aws-samples/amazon-freertos-iot-conveyor-belt/README.md

## IoT Conveyor Belt

A 3D Printed Conveyor belt that runs Amazon FreeRTOS to control conveyor direction and report conveyor telemetry data using Amazon's IoT service.

## License

This library is licensed under the Apache 2.0 License.
