aws-samples/amazon-freertos-iot-conveyor-belt/conveyor-design-files/README.md

# Assembly Instructions Coming Soon!
We are currently working on detailed assembly instructions and a bill of materials so you can build a conveyor belt your self. [Check out the assembly-instructions branch to see the work in progress](
https://github.com/aws-samples/amazon-freertos-iot-conveyor-belt/tree/assembly-instructions/conveyor-design-files/assembly-instructions)
