aws-samples/amazon-freertos-iot-conveyor-belt/conveyor-design-files/assembly-instructions/BOM.md

# 3D Printed Parts

| Part | Quantity | Link |
|---|---|---|
| Front | 1 | https://github.com/aws-samples/amazon-freertos-iot-conveyor-belt/blob/master/conveyor-design-files/3d-stl-files/conveyor-front-one-piece.stl |
| Back | 1 | https://github.com/aws-samples/amazon-freertos-iot-conveyor-belt/blob/master/conveyor-design-files/3d-stl-files/conveyor-back-one-piece.stl |
| Center | 1 | https://github.com/aws-samples/amazon-freertos-iot-conveyor-belt/blob/master/conveyor-design-files/3d-stl-files/conveyor-center.stl |
| Belt Pulley | 2 | https://github.com/aws-samples/amazon-freertos-iot-conveyor-belt/blob/master/conveyor-design-files/3d-stl-files/conveyor-belt-pully-v2.stl |
| Drive Belt Cover | 1 | https://github.com/aws-samples/amazon-freertos-iot-conveyor-belt/blob/master/conveyor-design-files/3d-stl-files/conveyor-drive-belt-cover.stl |
| Switch Cover | 1 | https://github.com/aws-samples/amazon-freertos-iot-conveyor-belt/blob/master/conveyor-design-files/3d-stl-files/conveyor-switch-cover.stl |
| Conveyor Leg | 2 | https://github.com/aws-samples/amazon-freertos-iot-conveyor-belt/blob/master/conveyor-design-files/3d-stl-files/conveyor-leg.stl |
| Rear Access Port | 1 | https://github.com/aws-samples/amazon-freertos-iot-conveyor-belt/blob/master/conveyor-design-files/3d-stl-files/conveyor-back-access-port-cover.stl |

# Electrical Components
| Part | Quantity | Link |
|---|---|---|
| Circuit Board | 1 | https://github.com/aws-samples/amazon-freertos-iot-conveyor-belt/tree/master/conveyor-design-files/pcb-files |
| ESP32 DevKit V1 | 1 | https://www.amazon.com/gp/product/B0718T232Z/ref=oh_aui_detailpage_o02_s00?ie=UTF8&psc=1 |
| DRV8834 Stepper Controller | 1 | https://www.pololu.com/product/2134 |
| NEMA17 Stepper Motor | 1 | https://www.amazon.com/gp/product/B01GNAN2U0/ref=oh_aui_detailpage_o08_s03?ie=UTF8&psc=1 |
| 100uF Capacitor | 1 | https://www.amazon.com/Bluesky-50PCS-Radial-Electrolytic-Capacitor/dp/B01K9IGBBY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 |
| ADXL335 | 1 | https://www.amazon.com/gp/product/B00NAY2TUC/ref=oh_aui_detailpage_o01_s00?ie=UTF8&psc=1 |
| A1120 Hall Effect Sensor | 1 | https://www.amazon.com/gp/product/B00SWK15ZE/ref=ppx_yo_dt_b_asin_title_o04_s03?ie=UTF8&psc=1 |
| USB Micro-B Breakout | 1 | https://www.amazon.com/gp/product/B00KLDPZVU/ref=ppx_yo_dt_b_asin_title_o05_s05?ie=UTF8&psc=1 |
| Toggle Switch | 1 | https://www.amazon.com/gp/product/B0725V1Z54/ref=oh_aui_detailpage_o09_s00?ie=UTF8&psc=1 |
| Ribbon Cable | 1 | https://www.amazon.com/Ribbon-Cable-10-wire-15ft/dp/B007R9SQQM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 |
| 2.54mm 3P Screw Terminal | 2 | https://www.amazon.com/gp/product/B07DG4798T/ref=oh_aui_detailpage_o05_s00?ie=UTF8&psc=1 |
| 2.54mm 2p Screw Terminal | 3 | https://www.amazon.com/gp/product/B07DG3GM42/ref=oh_aui_detailpage_o05_s00?ie=UTF8&psc=1 |
| 2.54mm female headers | 1 | https://www.amazon.com/ZYAMY-2-54mm-Female-Straight-Connector/dp/B0778F2MLW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 |
# Mechanical Components
| Part | Quantity | Link |
|---|---|---|
| 300H200 Timing Belt | 1 | https://www.amazon.com/PowerDrive-300H200-WOODS-MANUFACTURING-Replacement/dp/B00ISC73LG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 |
| 200 Tooth GT2 Timing Belt | 1 | https://www.amazon.com/gp/product/B074W229W1/ref=oh_aui_detailpage_o00_s01?ie=UTF8&psc=1 |
| 60 Tooth GT2 Timing Pully (8mm Bore) | 1 | https://www.amazon.com/gp/product/B01G1N1CI8/ref=oh_aui_detailpage_o00_s01?ie=UTF8&psc=1 |
| 16 Tooth GT2 Timing Pully (5mm Bore) | 1 | https://www.amazon.com/gp/product/B019GI5DVC/ref=od_aui_detailpages01?ie=UTF8&psc=1 |
| 608 Bearings | 4 | https://www.amazon.com/8x22x7-Shielded-Greased-Miniature-Bearings/dp/B00NX23HGQ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 |
| 100mm 8mm Threaded Rod | 2 | https://www.amazon.com/gp/product/B01B2WK13U/ref=ppx_yo_dt_b_asin_title_o02_s00?ie=UTF8&psc=1 |
| 6mm magnets | 9 | https://www.amazon.com/gp/product/B075RZ82HP/ref=oh_aui_detailpage_o00_s00?ie=UTF8&psc=1 |
| M3 Heat Set Inserts | 50 | https://www.amazon.com/gp/product/B077CL322T/ref=oh_aui_detailpage_o00_s01?ie=UTF8&psc=1 |
| M3X6mm Set Screw | 4 | https://www.amazon.com/uxcell-M3x6mm-Stainless-Socket-Screws/dp/B01AXVS7RS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 |
| M3X8mm Hex Screw | 50 | https://www.amazon.com/gp/product/B01M5DWCOW/ref=oh_aui_detailpage_o00_s01?ie=UTF8&psc=1 |
| M3X20mm Hex Screw | 4 | https://www.amazon.com/gp/product/B015A30R1I/ref=oh_aui_detailpage_o01_s00?ie=UTF8&psc=1 |
| M3 Washers | 4 | https://www.amazon.com/M3x6mmx0-5mm-Stainless-Steel-Washer-100Pcs/dp/B015A39NCC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 |
| M8 Nylock Hex Nut | 7 | https://www.amazon.com/uxcell-1-25mm-Stainless-Nylock-Insert/dp/B01M28GRLR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 |
| M2X4mm Self Tapping Screw | 2 | https://www.amazon.com/gp/product/B0775ZKB2H/ref=ppx_yo_dt_b_asin_title_o04_s00?ie=UTF8&psc=1 |
