aws-samples/amazon-freertos-iot-conveyor-belt/conveyor-design-files/3d-stl-files/conveyor-belt-pully-v2.stl

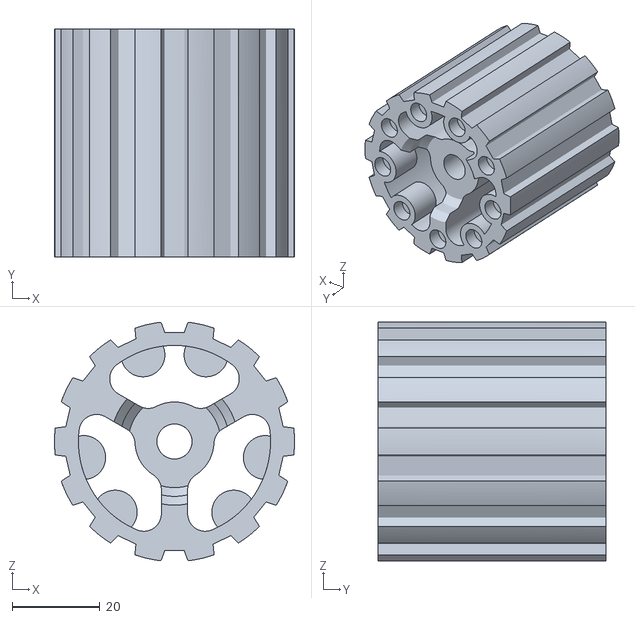
[picture p10: CAD file, 2019-09-26]
conveyor-design-files/3d-stl-files/conveyor-belt-pully-v2.stl
54.7 x 52.0 x 54.3
