aws-samples/amazon-freertos-iot-conveyor-belt/conveyor-design-files/3d-stl-files/conveyor-shortleg.stl

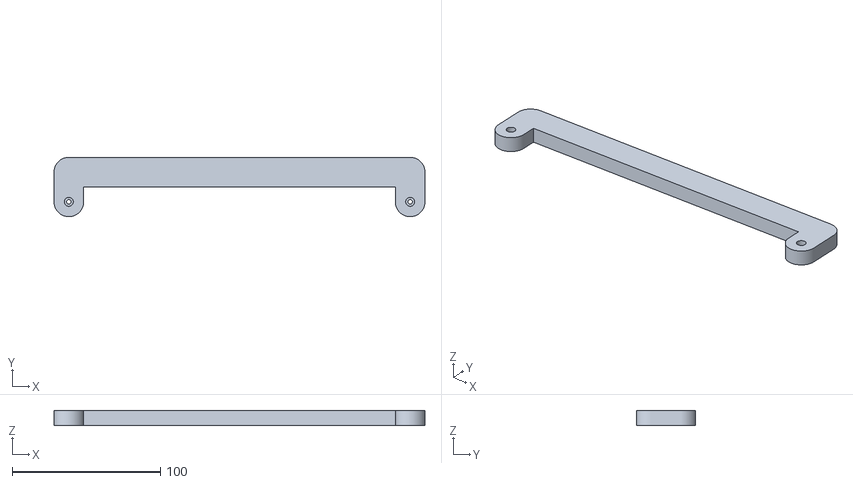
[picture p11: CAD file, 2019-01-02]
conveyor-design-files/3d-stl-files/conveyor-shortleg.stl
250.0 x 40.0 x 10.0
