aws-samples/amazon-freertos-iot-conveyor-belt/conveyor-design-files/3d-stl-files/conveyor-center.stl

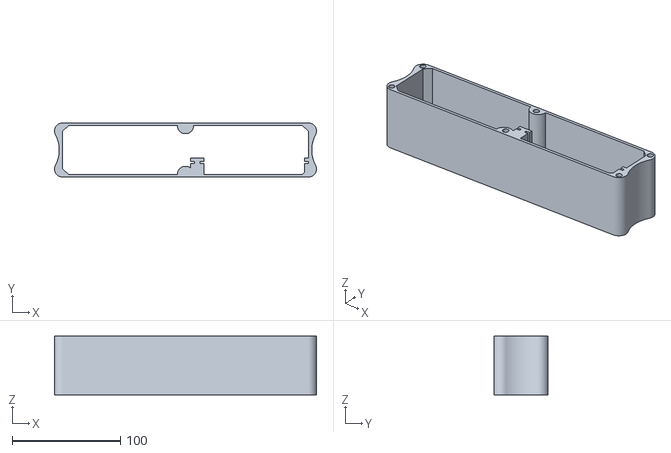
[picture p12: CAD file, 2018-11-28]
conveyor-design-files/3d-stl-files/conveyor-center.stl
241.7 x 50.0 x 54.0
