aws-samples/amazon-freertos-iot-conveyor-belt/conveyor-design-files/3d-stl-files/conveyor-drive-belt-cover.stl

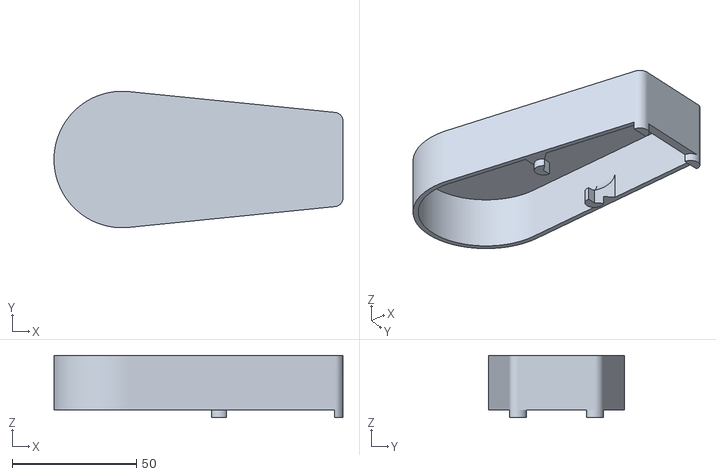
[picture p13: CAD file, 2018-11-28]
conveyor-design-files/3d-stl-files/conveyor-drive-belt-cover.stl
116.5 x 55.0 x 25.0
