aws-samples/amazon-freertos-iot-conveyor-belt/conveyor-design-files/3d-stl-files/conveyor-back-one-piece.stl

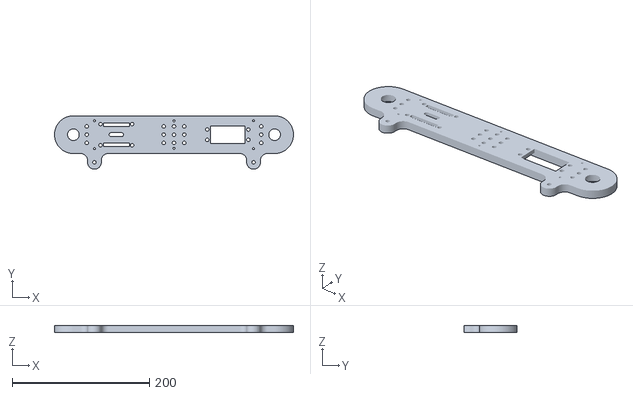
[picture p16: CAD file, 2018-11-28]
conveyor-design-files/3d-stl-files/conveyor-back-one-piece.stl
348.0 x 77.8 x 10.0
