aws-samples/amazon-freertos-iot-conveyor-belt/conveyor-design-files/3d-stl-files/conveyor-front-left.stl

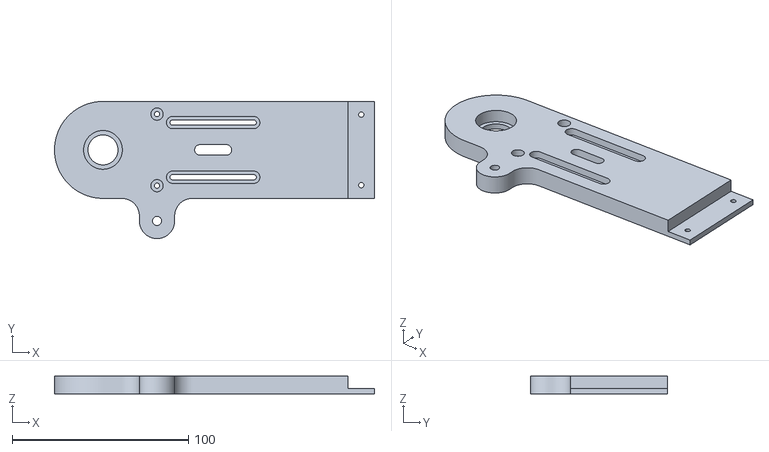
[picture p17: CAD file, 2018-11-28]
conveyor-design-files/3d-stl-files/conveyor-front-left.stl
181.5 x 77.8 x 10.0
