aws-samples/amazon-freertos-iot-conveyor-belt/conveyor-design-files/3d-stl-files/deeplens-attachment.stl

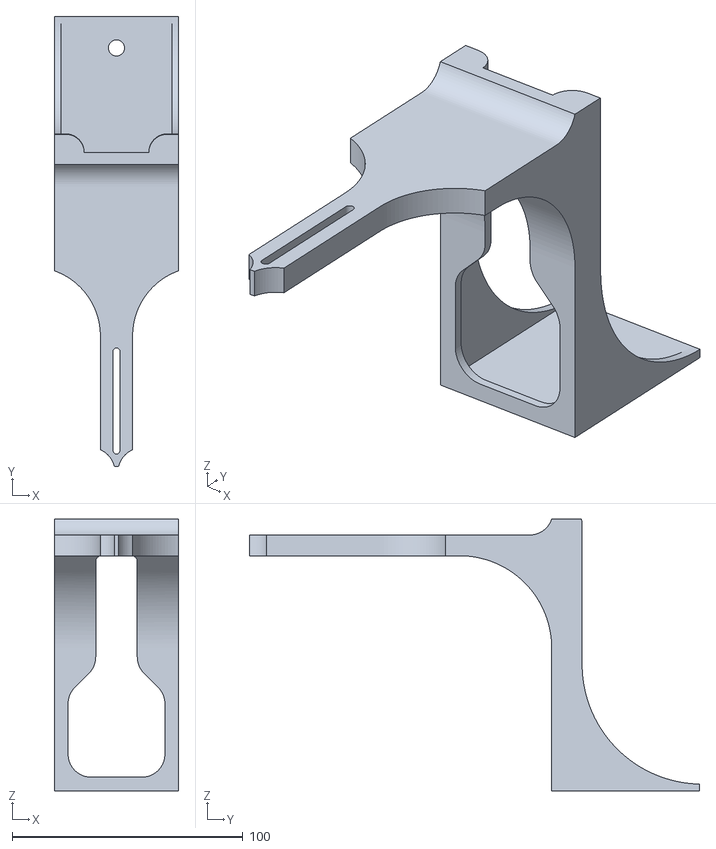
[picture p18: CAD file, 2018-11-28]
conveyor-design-files/3d-stl-files/deeplens-attachment.stl
54.0 x 195.4 x 118.0
