aws-samples/amazon-freertos-iot-conveyor-belt/conveyor-design-files/3d-stl-files/conveyor-back-access-port-cover.stl

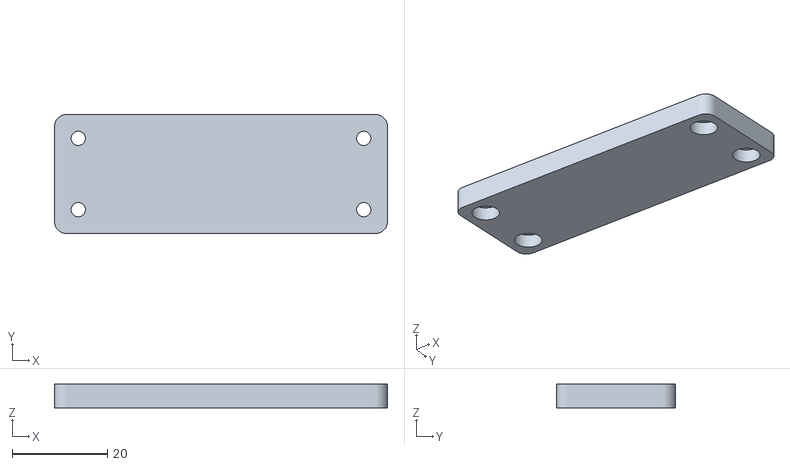
[picture p19: CAD file, 2018-11-28]
conveyor-design-files/3d-stl-files/conveyor-back-access-port-cover.stl
70.0 x 25.0 x 5.00
