aws-samples/amazon-freertos-iot-conveyor-belt/conveyor-design-files/3d-stl-files/conveyor-leg.stl

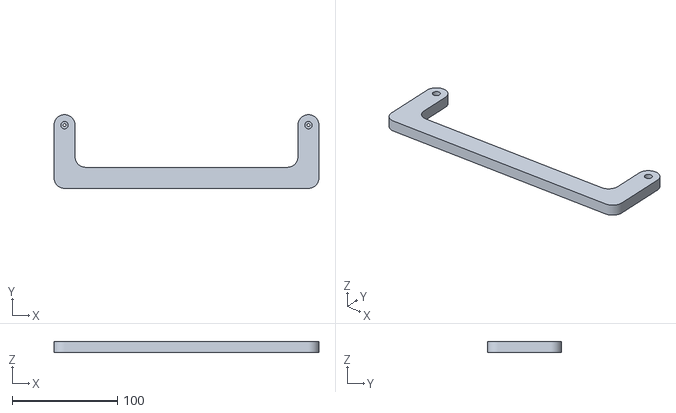
[picture p20: CAD file, 2018-11-28]
conveyor-design-files/3d-stl-files/conveyor-leg.stl
251.7 x 70.0 x 10.0
