aws-samples/amazon-freertos-iot-conveyor-belt/conveyor-design-files/3d-stl-files/conveyor-switch-cover.stl

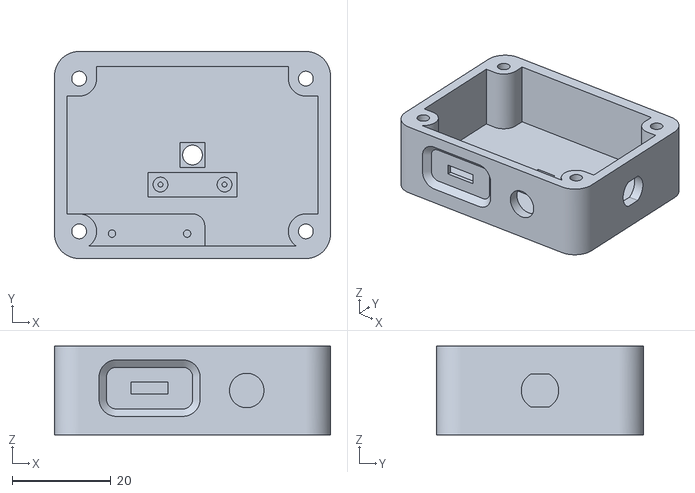
[picture p21: CAD file, 2018-11-28]
conveyor-design-files/3d-stl-files/conveyor-switch-cover.stl
56.0 x 42.0 x 18.0
