aws-samples/amazon-freertos-iot-conveyor-belt/conveyor-design-files/3d-stl-files/conveyor-belt-pully.stl

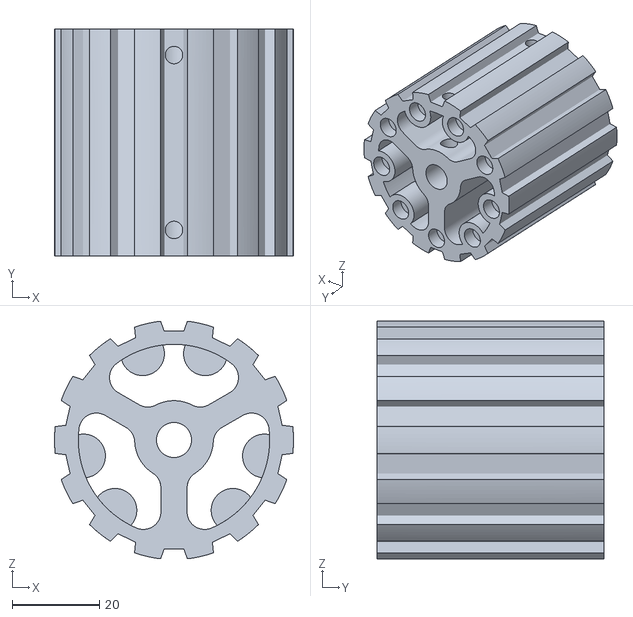
[picture p22: CAD file, 2018-11-28, an earlier design]
conveyor-design-files/3d-stl-files/conveyor-belt-pully.stl
54.7 x 52.0 x 54.3
