aws-samples/amazon-freertos-iot-conveyor-belt/(list of files, cad)

Other CAD files:
conveyor-design-files/3d-stl-files/conveyor-front-one-piece.stl
conveyor-design-files/3d-stl-files/conveyor-back-left.stl
