aws-samples/amazon-freertos-iot-conveyor-belt/conveyor-design-files/assembly-instructions/images/wiring_routing.jpg

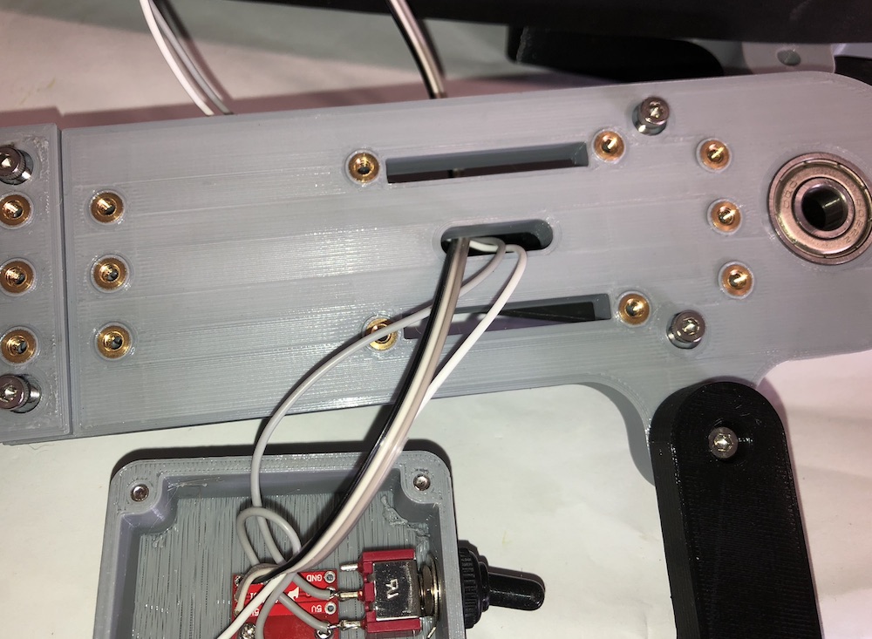
conveyor-design-files/assembly-instructions/images/wiring_routing.jpg
