aws-samples/amazon-freertos-iot-conveyor-belt/conveyor-design-files/pcb-files/conveyor-pcb.brd

## EAGLE design conveyor-design-files/pcb-files/conveyor-pcb.brd (2018-11-28)

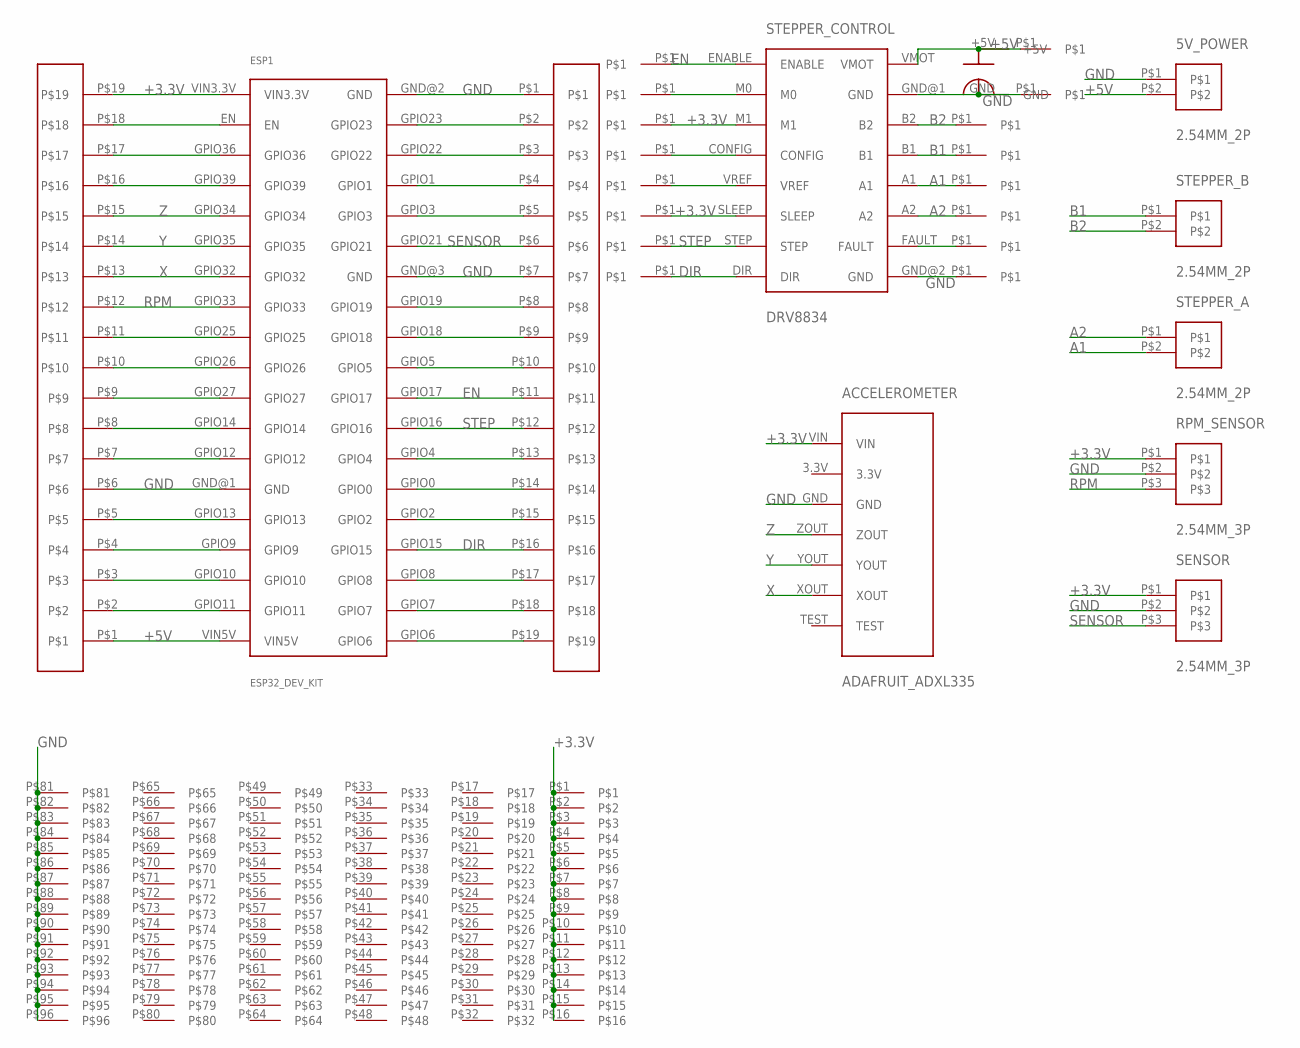
[picture p46: schematic conveyor-pcb.sch]

Parts:
5V_POWER: 2.54MM_2P
ACCELEROMETER: ADAFRUIT_ADXL335
ESP1: ESP32_DEV_KIT
RPM_SENSOR: 2.54MM_3P
SENSOR: 2.54MM_3P
STEPPER_A: 2.54MM_2P
STEPPER_B: 2.54MM_2P
STEPPER_CONTROL: DRV8834
U$1, U$2: 19PINHEADER
U$3: PERFBOARD_CONVEYOR
U$4, U$5, U$6, U$7, U$8, U$9, U$10, U$11, U$12, U$13, U$14, U$15, U$16, U$17, U$18, U$19: 1PIN_HEADER
U$20: CAP_100UF

Connections:
+3.3V: ACCELEROMETER.VIN, ESP1.VIN3.3V, RPM_SENSOR.P$1, SENSOR.P$1, STEPPER_CONTROL.M1, STEPPER_CONTROL.SLEEP, U$2.P$19, U$3.P$1, U$3.P$2, U$3.P$3, U$3.P$4, U$3.P$5, U$3.P$6, U$3.P$7, U$3.P$8, U$3.P$9, U$3.P$10, U$3.P$11, U$3.P$12, U$3.P$13, U$3.P$14, U$3.P$15, U$3.P$16, U$6.P$1, U$9.P$1
+5V: 5V_POWER.P$2, ESP1.VIN5V, STEPPER_CONTROL.VMOT, U$2.P$1, U$19.P$1, U$20.+5V
A1: STEPPER_A.P$2, STEPPER_CONTROL.A1, U$15.P$1
A2: STEPPER_A.P$1, STEPPER_CONTROL.A2, U$14.P$1
B1: STEPPER_B.P$1, STEPPER_CONTROL.B1, U$16.P$1
B2: STEPPER_B.P$2, STEPPER_CONTROL.B2, U$17.P$1
DIR: ESP1.GPIO15, STEPPER_CONTROL.DIR, U$1.P$16, U$11.P$1
EN: ESP1.GPIO17, STEPPER_CONTROL.ENABLE, U$1.P$11, U$4.P$1
GND: 5V_POWER.P$1, ACCELEROMETER.GND, ESP1.GND@1 (GND), ESP1.GND@2 (GND), ESP1.GND@3 (GND), RPM_SENSOR.P$2, SENSOR.P$2, STEPPER_CONTROL.GND@1 (GND), STEPPER_CONTROL.GND@2 (GND), U$1.P$1, U$1.P$7, U$2.P$6, U$3.P$81, U$3.P$82, U$3.P$83, U$3.P$84, U$3.P$85, U$3.P$86, U$3.P$87, U$3.P$88, U$3.P$89, U$3.P$90, U$3.P$91, U$3.P$92, U$3.P$93, U$3.P$94, U$3.P$95, U$3.P$96, U$12.P$1, U$18.P$1, U$20.GND
unnamed: STEPPER_CONTROL.M0, U$5.P$1
unnamed: STEPPER_CONTROL.CONFIG, U$7.P$1
unnamed: STEPPER_CONTROL.VREF, U$8.P$1
unnamed: ESP1.GPIO11, U$2.P$2
unnamed: ESP1.GPIO10, U$2.P$3
unnamed: ESP1.GPIO9, U$2.P$4
unnamed: ESP1.GPIO13, U$2.P$5
unnamed: ESP1.GPIO12, U$2.P$7
unnamed: ESP1.GPIO27, U$2.P$9
unnamed: ESP1.GPIO26, U$2.P$10
unnamed: ESP1.GPIO25, U$2.P$11
unnamed: STEPPER_CONTROL.FAULT, U$13.P$1
unnamed: ESP1.EN, U$2.P$18
unnamed: ESP1.GPIO23, U$1.P$2
unnamed: ESP1.GPIO22, U$1.P$3
unnamed: ESP1.GPIO1, U$1.P$4
unnamed: ESP1.GPIO3, U$1.P$5
unnamed: ESP1.GPIO19, U$1.P$8
unnamed: ESP1.GPIO18, U$1.P$9
unnamed: ESP1.GPIO36, U$2.P$17
unnamed: ESP1.GPIO5, U$1.P$10
unnamed: ESP1.GPIO4, U$1.P$13
unnamed: ESP1.GPIO0, U$1.P$14
unnamed: ESP1.GPIO2, U$1.P$15
unnamed: ESP1.GPIO8, U$1.P$17
unnamed: ESP1.GPIO7, U$1.P$18
unnamed: ESP1.GPIO6, U$1.P$19
P$8: ESP1.GPIO14, U$2.P$8
P$16: ESP1.GPIO39, U$2.P$16
RPM: ESP1.GPIO33, RPM_SENSOR.P$3, U$2.P$12
SENSOR: ESP1.GPIO21, SENSOR.P$3, U$1.P$6
STEP: ESP1.GPIO16, STEPPER_CONTROL.STEP, U$1.P$12, U$10.P$1
X: ACCELEROMETER.XOUT, ESP1.GPIO32, U$2.P$13
Y: ACCELEROMETER.YOUT, ESP1.GPIO35, U$2.P$14
Z: ACCELEROMETER.ZOUT, ESP1.GPIO34, U$2.P$15

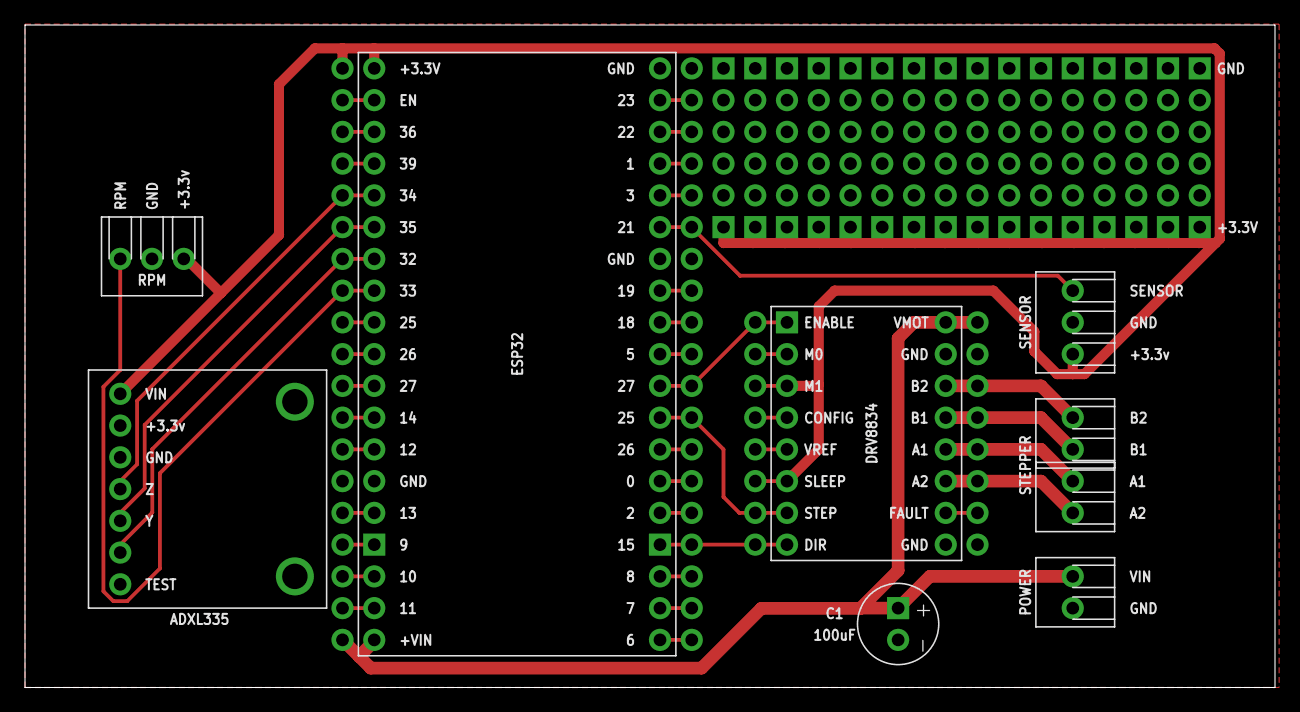
[picture p47: board conveyor-pcb.brd from above]

Board: 2 copper layers, 100.0 x 53.0 mm, 28 parts (0 on the bottom side), 44 nets.
