aws-samples/amazon-freertos-iot-conveyor-belt/(commit log)

2018-11-09 Adding conveyor code
2018-11-20 Adding pcb design files
    [conveyor-pcb.brd, conveyor-pcb.sch]
2018-11-20 Adding STL files
    [conveyor-back-access-port-cover.stl, conveyor-back-left.stl, conveyor-back-one-piece.stl, conveyor-back-right.stl, conveyor-belt-pully.stl, conveyor-center.stl, conveyor-drive-belt-cover.stl, conveyor-front-left.stl]
2018-11-21 updates to pcb files
    [conveyor-pcb.brd, conveyor-pcb.sch]
2018-11-21 adding copyright to PCB files
    [conveyor-pcb.brd, conveyor-pcb.sch]
2018-11-28 stub for assembly instructions
2018-11-28 adding Bill of Materials
2018-11-28 Electronics and 3D printing instructions
2018-12-15 fleshing out the heat set insert section
2018-12-15 fleshing out pulley section
2018-12-15 adding link to assembly-instructions branch
2018-12-20 adding pulley assembly instructions
2018-12-20 removed heat set insert section from pulley section
2018-12-20 fleshing out electronics section, minor fixes to 3d printing section
2018-12-21 fleshing out final assembly instructions
2018-12-21 adding more instructions to final assembly section
2018-12-22 Shorter legs for smaller printers
    Shortened legs for 3-D printing, that will fit smaller printers (210x210mm printbed size) in stl and OpenSCAD format(http://www.openscad.org/) format.
    [conveyor-shortleg.scad, conveyor-shortleg.stl]
2019-09-26 Updating Documentation Links
    The Expressif ESP32 documentation has changed for new versions so the referenced links are no longer valid. Updated the links to reference the ESP32 tool chain version that we are using.
2019-09-26 New version of conveyor belt pulley
    This is a new design for the conveyor belt drive pulley and idler pulley. Instead of using heat set inserts and a set screw to hold the M8 rod in place, the new design uses two M8 lock nuts that are recessed in the pulley.
    [conveyor-belt-pully-v2.stl]
2019-11-12 Updated BOM
    Added addition M8 nuts and M2 4mm screws
2019-11-12 Update BOM Links
2019-11-14 Update aws_conveyor_telemetry.c
    Fixed conflicting clientid
    [aws_conveyor_telemetry.c]
